zhhangBian/BOOM_chip/总线/总线.md

# 总结信号梳理和实例化

## AXI-Interconnect信号梳理

```verilog

/*
 * AXI4 interconnect
 */
module axi_interconnect #
(
    // Number of AXI inputs (slave interfaces)
    parameter S_COUNT = 4, // 接axi-bridge == 1
    // Number of AXI outputs (master interfaces)
    parameter M_COUNT = 4, // 接其他外设
    // Width of data bus in bits
    parameter DATA_WIDTH = 32, // 不用改
    // Width of address bus in bits
    parameter ADDR_WIDTH = 32, // 不用改
    // Width of wstrb (width of data bus in words)
    parameter STRB_WIDTH = (DATA_WIDTH/8), // 不用改
    // Width of ID signal 
    parameter ID_WIDTH = 8, // 取决于实际用的id位宽。官方包里的bridge是 4 ，但是这个模块里面似乎根本没用到 axi 的 id 信号
    // Propagate awuser signal
    parameter AWUSER_ENABLE = 0, // 不用改
    // Width of awuser signal
    parameter AWUSER_WIDTH = 1, // 不用改
    // Propagate wuser signal
    parameter WUSER_ENABLE = 0, // 不用改
    // Width of wuser signal
    parameter WUSER_WIDTH = 1, // 不用改
    // Propagate buser signal
    parameter BUSER_ENABLE = 0, // 不用功
    // Width of buser signal
    parameter BUSER_WIDTH = 1, // 不用改
    // Propagate aruser signal
    parameter ARUSER_ENABLE = 0, // 不用改
    // Width of aruser signal
    parameter ARUSER_WIDTH = 1, // 不用改
    // Propagate ruser signal
    parameter RUSER_ENABLE = 0, // 不用改
    // Width of ruser signal
    parameter RUSER_WIDTH = 1, // 不用改
    // Propagate ID field
    parameter FORWARD_ID = 0, // 应该不用改
    // Number of regions per master interface
    parameter M_REGIONS = 1, // 我们应该用默认值就行
    // Master interface base addresses
    // M_COUNT concatenated fields of M_REGIONS concatenated fields of ADDR_WIDTH bits
    // set to zero for default addressing based on M_ADDR_WIDTH
    parameter M_BASE_ADDR = 0, // 外设端的地址基址。没有特殊要求的话默认是 0 就好了
    // Master interface address widths
    // M_COUNT concatenated fields of M_REGIONS concatenated fields of 32 bits
    parameter M_ADDR_WIDTH = {M_COUNT{{M_REGIONS{32'd24}}}}, // 外设端的地址位宽。默认为均为24位，一般不得超出 ADDR_WIDTH 
    // Read connections between interfaces
    // M_COUNT concatenated fields of S_COUNT bits
    parameter M_CONNECT_READ = {M_COUNT{{S_COUNT{1'b1}}}}, // 取决于哪些设备是读
    // Write connections between interfaces
    // M_COUNT concatenated fields of S_COUNT bits
    parameter M_CONNECT_WRITE = {M_COUNT{{S_COUNT{1'b1}}}}, // 取决于哪些设备是写
    // Secure master (fail operations based on awprot/arprot)
    // M_COUNT bits
    parameter M_SECURE = {M_COUNT{1'b0}} // 我们应该不使用 secure 
)
(
    input  wire                            clk,
    input  wire                            rst,

    /*
     * AXI slave interfaces
     */
    input  wire [S_COUNT*ID_WIDTH-1:0]     s_axi_awid,
    input  wire [S_COUNT*ADDR_WIDTH-1:0]   s_axi_awaddr, // 
    input  wire [S_COUNT*8-1:0]            s_axi_awlen,
    input  wire [S_COUNT*3-1:0]            s_axi_awsize,
    input  wire [S_COUNT*2-1:0]            s_axi_awburst,
    input  wire [S_COUNT-1:0]              s_axi_awlock,
    input  wire [S_COUNT*4-1:0]            s_axi_awcache,
    input  wire [S_COUNT*3-1:0]            s_axi_awprot,
    input  wire [S_COUNT*4-1:0]            s_axi_awqos,
    input  wire [S_COUNT*AWUSER_WIDTH-1:0] s_axi_awuser,
    input  wire [S_COUNT-1:0]              s_axi_awvalid,
    output wire [S_COUNT-1:0]              s_axi_awready,
    input  wire [S_COUNT*DATA_WIDTH-1:0]   s_axi_wdata,
    input  wire [S_COUNT*STRB_WIDTH-1:0]   s_axi_wstrb,
    input  wire [S_COUNT-1:0]              s_axi_wlast,
    input  wire [S_COUNT*WUSER_WIDTH-1:0]  s_axi_wuser,
    input  wire [S_COUNT-1:0]              s_axi_wvalid,
    output wire [S_COUNT-1:0]              s_axi_wready,
    output wire [S_COUNT*ID_WIDTH-1:0]     s_axi_bid,
    output wire [S_COUNT*2-1:0]            s_axi_bresp,
    output wire [S_COUNT*BUSER_WIDTH-1:0]  s_axi_buser,
    output wire [S_COUNT-1:0]              s_axi_bvalid,
    input  wire [S_COUNT-1:0]              s_axi_bready,
    input  wire [S_COUNT*ID_WIDTH-1:0]     s_axi_arid,
    input  wire [S_COUNT*ADDR_WIDTH-1:0]   s_axi_araddr,
    input  wire [S_COUNT*8-1:0]            s_axi_arlen,
    input  wire [S_COUNT*3-1:0]            s_axi_arsize,
    input  wire [S_COUNT*2-1:0]            s_axi_arburst,
    input  wire [S_COUNT-1:0]              s_axi_arlock,
    input  wire [S_COUNT*4-1:0]            s_axi_arcache,
    input  wire [S_COUNT*3-1:0]            s_axi_arprot,
    input  wire [S_COUNT*4-1:0]            s_axi_arqos,
    input  wire [S_COUNT*ARUSER_WIDTH-1:0] s_axi_aruser,
    input  wire [S_COUNT-1:0]              s_axi_arvalid,
    output wire [S_COUNT-1:0]              s_axi_arready,
    output wire [S_COUNT*ID_WIDTH-1:0]     s_axi_rid,
    output wire [S_COUNT*DATA_WIDTH-1:0]   s_axi_rdata,
    output wire [S_COUNT*2-1:0]            s_axi_rresp,
    output wire [S_COUNT-1:0]              s_axi_rlast,
    output wire [S_COUNT*RUSER_WIDTH-1:0]  s_axi_ruser,
    output wire [S_COUNT-1:0]              s_axi_rvalid,
    input  wire [S_COUNT-1:0]              s_axi_rready,

    /*
     * AXI master interfaces
     */
    output wire [M_COUNT*ID_WIDTH-1:0]     m_axi_awid,
    output wire [M_COUNT*ADDR_WIDTH-1:0]   m_axi_awaddr,
    output wire [M_COUNT*8-1:0]            m_axi_awlen,
    output wire [M_COUNT*3-1:0]            m_axi_awsize,
    output wire [M_COUNT*2-1:0]            m_axi_awburst,
    output wire [M_COUNT-1:0]              m_axi_awlock,
    output wire [M_COUNT*4-1:0]            m_axi_awcache,
    output wire [M_COUNT*3-1:0]            m_axi_awprot,
    output wire [M_COUNT*4-1:0]            m_axi_awqos,
    output wire [M_COUNT*4-1:0]            m_axi_awregion,
    output wire [M_COUNT*AWUSER_WIDTH-1:0] m_axi_awuser,
    output wire [M_COUNT-1:0]              m_axi_awvalid,
    input  wire [M_COUNT-1:0]              m_axi_awready,
    output wire [M_COUNT*DATA_WIDTH-1:0]   m_axi_wdata,
    output wire [M_COUNT*STRB_WIDTH-1:0]   m_axi_wstrb,
    output wire [M_COUNT-1:0]              m_axi_wlast,
    output wire [M_COUNT*WUSER_WIDTH-1:0]  m_axi_wuser,
    output wire [M_COUNT-1:0]              m_axi_wvalid,
    input  wire [M_COUNT-1:0]              m_axi_wready,
    input  wire [M_COUNT*ID_WIDTH-1:0]     m_axi_bid,
    input  wire [M_COUNT*2-1:0]            m_axi_bresp,
    input  wire [M_COUNT*BUSER_WIDTH-1:0]  m_axi_buser,
    input  wire [M_COUNT-1:0]              m_axi_bvalid,
    output wire [M_COUNT-1:0]              m_axi_bready,
    output wire [M_COUNT*ID_WIDTH-1:0]     m_axi_arid,
    output wire [M_COUNT*ADDR_WIDTH-1:0]   m_axi_araddr,
    output wire [M_COUNT*8-1:0]            m_axi_arlen,
    output wire [M_COUNT*3-1:0]            m_axi_arsize,
    output wire [M_COUNT*2-1:0]            m_axi_arburst,
    output wire [M_COUNT-1:0]              m_axi_arlock,
    output wire [M_COUNT*4-1:0]            m_axi_arcache,
    output wire [M_COUNT*3-1:0]            m_axi_arprot,
    output wire [M_COUNT*4-1:0]            m_axi_arqos,
    output wire [M_COUNT*4-1:0]            m_axi_arregion,
    output wire [M_COUNT*ARUSER_WIDTH-1:0] m_axi_aruser,
    output wire [M_COUNT-1:0]              m_axi_arvalid,
    input  wire [M_COUNT-1:0]              m_axi_arready,
    input  wire [M_COUNT*ID_WIDTH-1:0]     m_axi_rid,
    input  wire [M_COUNT*DATA_WIDTH-1:0]   m_axi_rdata,
    input  wire [M_COUNT*2-1:0]            m_axi_rresp,
    input  wire [M_COUNT-1:0]              m_axi_rlast,
    input  wire [M_COUNT*RUSER_WIDTH-1:0]  m_axi_ruser,
    input  wire [M_COUNT-1:0]              m_axi_rvalid,
    output wire [M_COUNT-1:0]              m_axi_rready
);

```

## AXI-BRIDGE的信号梳理

```verilog
/*
 * AXI4 crossbar
 */
module axi_crossbar #
(
    // Number of AXI inputs (slave interfaces)
    parameter S_COUNT = 4, // 连接两个cache, == 2
    // Number of AXI outputs (master interfaces)
    parameter M_COUNT = 4, // 连接总线，== 1
    // Width of data bus in bits
    parameter DATA_WIDTH = 32, // 数据位宽
    // Width of address bus in bits
    parameter ADDR_WIDTH = 32, // 
    // Width of wstrb (width of data bus in words)
    parameter STRB_WIDTH = (DATA_WIDTH/8),
    // Input ID field width (from AXI masters)
    parameter S_ID_WIDTH = 8, // 官方包是 4
    // Output ID field width (towards AXI slaves)
    // Additional bits required for response routing
    parameter M_ID_WIDTH = S_ID_WIDTH+$clog2(S_COUNT),
    // Propagate awuser signal
    parameter AWUSER_ENABLE = 0, 
    // Width of awuser signal // 不需要
    parameter AWUSER_WIDTH = 1,
    // Propagate wuser signal
    parameter WUSER_ENABLE = 0,
    // Width of wuser signal
    parameter WUSER_WIDTH = 1,
    // Propagate buser signal
    parameter BUSER_ENABLE = 0,
    // Width of buser signal
    parameter BUSER_WIDTH = 1,
    // Propagate aruser signal
    parameter ARUSER_ENABLE = 0,
    // Width of aruser signal
    parameter ARUSER_WIDTH = 1,
    // Propagate ruser signal
    parameter RUSER_ENABLE = 0,
    // Width of ruser signal
    parameter RUSER_WIDTH = 1,
    // Number of concurrent unique IDs for each slave interface
    // S_COUNT concatenated fields of 32 bits
    parameter S_THREADS = {S_COUNT{32'd2}}, // 我们应该是设置成 1 吧
    // Number of concurrent operations for each slave interface
    // S_COUNT concatenated fields of 32 bits
    parameter S_ACCEPT = {S_COUNT{32'd16}}, // ???
    // Number of regions per master interface
    parameter M_REGIONS = 1,
    // Master interface base addresses
    // M_COUNT concatenated fields of M_REGIONS concatenated fields of ADDR_WIDTH bits
    // set to zero for default addressing based on M_ADDR_WIDTH
    parameter M_BASE_ADDR = 0,
    // Master interface address widths
    // M_COUNT concatenated fields of M_REGIONS concatenated fields of 32 bits
    parameter M_ADDR_WIDTH = {M_COUNT{{M_REGIONS{32'd24}}}},
    // Read connections between interfaces
    // M_COUNT concatenated fields of S_COUNT bits
    parameter M_CONNECT_READ = {M_COUNT{{S_COUNT{1'b1}}}}, // 应该是全部设置成 1，即都可读
    // Write connections between interfaces
    // M_COUNT concatenated fields of S_COUNT bits
    parameter M_CONNECT_WRITE = {M_COUNT{{S_COUNT{1'b1}}}}, // 设置成仅 DCache 侧可写
    // Number of concurrent operations for each master interface
    // M_COUNT concatenated fields of 32 bits
    parameter M_ISSUE = {M_COUNT{32'd4}}, // master侧支持的并发数量，感觉设置成 1 就行吧。毕竟只有一个master interface
    // Secure master (fail operations based on awprot/arprot)
    // M_COUNT bits
    parameter M_SECURE = {M_COUNT{1'b0}},
    // Slave interface AW channel register type (input)
    // 0 to bypass, 1 for simple buffer, 2 for skid buffer
    parameter S_AW_REG_TYPE = {S_COUNT{2'd0}},
    // Slave interface W channel register type (input)
    // 0 to bypass, 1 for simple buffer, 2 for skid buffer
    parameter S_W_REG_TYPE = {S_COUNT{2'd0}},
    // Slave interface B channel register type (output)
    // 0 to bypass, 1 for simple buffer, 2 for skid buffer
    parameter S_B_REG_TYPE = {S_COUNT{2'd1}},
    // Slave interface AR channel register type (input)
    // 0 to bypass, 1 for simple buffer, 2 for skid buffer
    parameter S_AR_REG_TYPE = {S_COUNT{2'd0}},
    // Slave interface R channel register type (output)
    // 0 to bypass, 1 for simple buffer, 2 for skid buffer
    parameter S_R_REG_TYPE = {S_COUNT{2'd2}},
    // Master interface AW channel register type (output)
    // 0 to bypass, 1 for simple buffer, 2 for skid buffer
    parameter M_AW_REG_TYPE = {M_COUNT{2'd1}}, // M开头的 REG_TYPE 都不会用到
    // Master interface W channel register type (output)
    // 0 to bypass, 1 for simple buffer, 2 for skid buffer
    parameter M_W_REG_TYPE = {M_COUNT{2'd2}},
    // Master interface B channel register type (input)
    // 0 to bypass, 1 for simple buffer, 2 for skid buffer
    parameter M_B_REG_TYPE = {M_COUNT{2'd0}},
    // Master interface AR channel register type (output)
    // 0 to bypass, 1 for simple buffer, 2 for skid buffer
    parameter M_AR_REG_TYPE = {M_COUNT{2'd1}},
    // Master interface R channel register type (input)
    // 0 to bypass, 1 for simple buffer, 2 for skid buffer
    parameter M_R_REG_TYPE = {M_COUNT{2'd0}}
)
(
    input  wire                             clk,
    input  wire                             rst,

    /*
     * AXI slave interfaces
     */
    input  wire [S_COUNT*S_ID_WIDTH-1:0]    s_axi_awid,
    input  wire [S_COUNT*ADDR_WIDTH-1:0]    s_axi_awaddr,
    input  wire [S_COUNT*8-1:0]             s_axi_awlen,
    input  wire [S_COUNT*3-1:0]             s_axi_awsize,
    input  wire [S_COUNT*2-1:0]             s_axi_awburst,
    input  wire [S_COUNT-1:0]               s_axi_awlock,
    input  wire [S_COUNT*4-1:0]             s_axi_awcache,
    input  wire [S_COUNT*3-1:0]             s_axi_awprot,
    input  wire [S_COUNT*4-1:0]             s_axi_awqos,
    input  wire [S_COUNT*AWUSER_WIDTH-1:0]  s_axi_awuser,
    input  wire [S_COUNT-1:0]               s_axi_awvalid,
    output wire [S_COUNT-1:0]               s_axi_awready,
    input  wire [S_COUNT*DATA_WIDTH-1:0]    s_axi_wdata,
    input  wire [S_COUNT*STRB_WIDTH-1:0]    s_axi_wstrb,
    input  wire [S_COUNT-1:0]               s_axi_wlast,
    input  wire [S_COUNT*WUSER_WIDTH-1:0]   s_axi_wuser,
    input  wire [S_COUNT-1:0]               s_axi_wvalid,
    output wire [S_COUNT-1:0]               s_axi_wready,
    output wire [S_COUNT*S_ID_WIDTH-1:0]    s_axi_bid,
    output wire [S_COUNT*2-1:0]             s_axi_bresp,
    output wire [S_COUNT*BUSER_WIDTH-1:0]   s_axi_buser,
    output wire [S_COUNT-1:0]               s_axi_bvalid,
    input  wire [S_COUNT-1:0]               s_axi_bready,
    input  wire [S_COUNT*S_ID_WIDTH-1:0]    s_axi_arid,
    input  wire [S_COUNT*ADDR_WIDTH-1:0]    s_axi_araddr,
    input  wire [S_COUNT*8-1:0]             s_axi_arlen,
    input  wire [S_COUNT*3-1:0]             s_axi_arsize,
    input  wire [S_COUNT*2-1:0]             s_axi_arburst,
    input  wire [S_COUNT-1:0]               s_axi_arlock,
    input  wire [S_COUNT*4-1:0]             s_axi_arcache,
    input  wire [S_COUNT*3-1:0]             s_axi_arprot,
    input  wire [S_COUNT*4-1:0]             s_axi_arqos,
    input  wire [S_COUNT*ARUSER_WIDTH-1:0]  s_axi_aruser,
    input  wire [S_COUNT-1:0]               s_axi_arvalid,
    output wire [S_COUNT-1:0]               s_axi_arready,
    output wire [S_COUNT*S_ID_WIDTH-1:0]    s_axi_rid,
    output wire [S_COUNT*DATA_WIDTH-1:0]    s_axi_rdata,
    output wire [S_COUNT*2-1:0]             s_axi_rresp,
    output wire [S_COUNT-1:0]               s_axi_rlast,
    output wire [S_COUNT*RUSER_WIDTH-1:0]   s_axi_ruser,
    output wire [S_COUNT-1:0]               s_axi_rvalid,
    input  wire [S_COUNT-1:0]               s_axi_rready,

    /*
     * AXI master interfaces
     */
    output wire [M_COUNT*M_ID_WIDTH-1:0]    m_axi_awid,
    output wire [M_COUNT*ADDR_WIDTH-1:0]    m_axi_awaddr,
    output wire [M_COUNT*8-1:0]             m_axi_awlen,
    output wire [M_COUNT*3-1:0]             m_axi_awsize,
    output wire [M_COUNT*2-1:0]             m_axi_awburst,
    output wire [M_COUNT-1:0]               m_axi_awlock,
    output wire [M_COUNT*4-1:0]             m_axi_awcache,
    output wire [M_COUNT*3-1:0]             m_axi_awprot,
    output wire [M_COUNT*4-1:0]             m_axi_awqos,
    output wire [M_COUNT*4-1:0]             m_axi_awregion,
    output wire [M_COUNT*AWUSER_WIDTH-1:0]  m_axi_awuser,
    output wire [M_COUNT-1:0]               m_axi_awvalid,
    input  wire [M_COUNT-1:0]               m_axi_awready,
    output wire [M_COUNT*DATA_WIDTH-1:0]    m_axi_wdata,
    output wire [M_COUNT*STRB_WIDTH-1:0]    m_axi_wstrb,
    output wire [M_COUNT-1:0]               m_axi_wlast,
    output wire [M_COUNT*WUSER_WIDTH-1:0]   m_axi_wuser,
    output wire [M_COUNT-1:0]               m_axi_wvalid,
    input  wire [M_COUNT-1:0]               m_axi_wready,
    input  wire [M_COUNT*M_ID_WIDTH-1:0]    m_axi_bid,
    input  wire [M_COUNT*2-1:0]             m_axi_bresp,
    input  wire [M_COUNT*BUSER_WIDTH-1:0]   m_axi_buser,
    input  wire [M_COUNT-1:0]               m_axi_bvalid,
    output wire [M_COUNT-1:0]               m_axi_bready,
    output wire [M_COUNT*M_ID_WIDTH-1:0]    m_axi_arid,
    output wire [M_COUNT*ADDR_WIDTH-1:0]    m_axi_araddr,
    output wire [M_COUNT*8-1:0]             m_axi_arlen,
    output wire [M_COUNT*3-1:0]             m_axi_arsize,
    output wire [M_COUNT*2-1:0]             m_axi_arburst,
    output wire [M_COUNT-1:0]               m_axi_arlock,
    output wire [M_COUNT*4-1:0]             m_axi_arcache,
    output wire [M_COUNT*3-1:0]             m_axi_arprot,
    output wire [M_COUNT*4-1:0]             m_axi_arqos,
    output wire [M_COUNT*4-1:0]             m_axi_arregion,
    output wire [M_COUNT*ARUSER_WIDTH-1:0]  m_axi_aruser,
    output wire [M_COUNT-1:0]               m_axi_arvalid,
    input  wire [M_COUNT-1:0]               m_axi_arready,
    input  wire [M_COUNT*M_ID_WIDTH-1:0]    m_axi_rid,
    input  wire [M_COUNT*DATA_WIDTH-1:0]    m_axi_rdata,
    input  wire [M_COUNT*2-1:0]             m_axi_rresp,
    input  wire [M_COUNT-1:0]               m_axi_rlast,
    input  wire [M_COUNT*RUSER_WIDTH-1:0]   m_axi_ruser,
    input  wire [M_COUNT-1:0]               m_axi_rvalid,
    output wire [M_COUNT-1:0]               m_axi_rready
);
```

```Verilog
// AXI-BRIDGE Instance
module axi_crossbar #
(
    S_COUNT         = 2, // 连接两个cache, == 2
    M_COUNT         = 1, // 连接总线，== 1
    DATA_WIDTH = 32, // TODO: 数据位宽
    ADDR_WIDTH      = 32, // 地址位宽，应该是32位吧
    // STRB_WIDTH = (DATA_WIDTH/8), // 使用默认值
    S_ID_WIDTH      = 4, // 官方包是 4 
    // parameter M_ID_WIDTH = S_ID_WIDTH+$clog2(S_COUNT), // 使用默认值
    // UESR SIGNAL信号全部都不需要
    // parameter S_THREADS = {S_COUNT{32'd2}}, // 我们应该是设置成 1 吧 TODO: 暂时使用默认值
    // parameter S_ACCEPT = {S_COUNT{32'd16}}, // TODO: 暂时使用默认值
    // parameter M_REGIONS = 1, // 使用默认值
    // parameter M_BASE_ADDR = 0, // 就一个master，设置成0就好
    // Master interface address widths
    // M_COUNT concatenated fields of M_REGIONS concatenated fields of 32 bits
    M_ADDR_WIDTH    = {M_COUNT{{M_REGIONS{32'd32}}}}, // ICACHE和DCACHE的数据位宽应该都是32位？TODO: 取决于物理地址宽度
    // parameter M_CONNECT_READ = {M_COUNT{{S_COUNT{1'b1}}}}, // 应该是全部设置成 1，即都可读
    M_CONNECT_WRITE = {M_COUNT{2'b01}}, // 设置成仅 DCache 侧可写
    // parameter M_ISSUE = {M_COUNT{32'd4}}, // TODO: master侧支持的并发数量, Number of concurrent operations for each master interface
    // parameter M_SECURE = {M_COUNT{1'b0}}, // 我们不需要SECURE

    // 0 to bypass, 1 for simple buffer, 2 for skid buffer
    // TODO: 暂时使用默认值
    // parameter S_AW_REG_TYPE = {S_COUNT{2'd0}},
    // parameter S_W_REG_TYPE = {S_COUNT{2'd0}},
    // parameter S_B_REG_TYPE = {S_COUNT{2'd1}},
    // parameter S_AR_REG_TYPE = {S_COUNT{2'd0}},
    // parameter S_R_REG_TYPE = {S_COUNT{2'd2}},

    // M开头的 REG_TYPE 根本不会用到
    // parameter M_AW_REG_TYPE = {M_COUNT{2'd1}}, 
    // parameter M_W_REG_TYPE = {M_COUNT{2'd2}},
    // parameter M_B_REG_TYPE = {M_COUNT{2'd0}},
    // parameter M_AR_REG_TYPE = {M_COUNT{2'd1}},
    // parameter M_R_REG_TYPE = {M_COUNT{2'd0}}
)
(
    input  wire                             clk,
    input  wire                             rst,

    /*
     * AXI slave interfaces
     */
    input  wire [S_COUNT*S_ID_WIDTH-1:0]    s_axi_awid,
    input  wire [S_COUNT*ADDR_WIDTH-1:0]    s_axi_awaddr,
    input  wire [S_COUNT*8-1:0]             s_axi_awlen,
    input  wire [S_COUNT*3-1:0]             s_axi_awsize,
    input  wire [S_COUNT*2-1:0]             s_axi_awburst,
    input  wire [S_COUNT-1:0]               s_axi_awlock,
    input  wire [S_COUNT*4-1:0]             s_axi_awcache,
    input  wire [S_COUNT*3-1:0]             s_axi_awprot,
    input  wire [S_COUNT*4-1:0]             s_axi_awqos,
    input  wire [S_COUNT*AWUSER_WIDTH-1:0]  s_axi_awuser,
    input  wire [S_COUNT-1:0]               s_axi_awvalid,
    output wire [S_COUNT-1:0]               s_axi_awready,
    input  wire [S_COUNT*DATA_WIDTH-1:0]    s_axi_wdata,
    input  wire [S_COUNT*STRB_WIDTH-1:0]    s_axi_wstrb,
    input  wire [S_COUNT-1:0]               s_axi_wlast,
    input  wire [S_COUNT*WUSER_WIDTH-1:0]   s_axi_wuser,
    input  wire [S_COUNT-1:0]               s_axi_wvalid,
    output wire [S_COUNT-1:0]               s_axi_wready,
    output wire [S_COUNT*S_ID_WIDTH-1:0]    s_axi_bid,
    output wire [S_COUNT*2-1:0]             s_axi_bresp,
    output wire [S_COUNT*BUSER_WIDTH-1:0]   s_axi_buser,
    output wire [S_COUNT-1:0]               s_axi_bvalid,
    input  wire [S_COUNT-1:0]               s_axi_bready,
    input  wire [S_COUNT*S_ID_WIDTH-1:0]    s_axi_arid,
    input  wire [S_COUNT*ADDR_WIDTH-1:0]    s_axi_araddr,
    input  wire [S_COUNT*8-1:0]             s_axi_arlen,
    input  wire [S_COUNT*3-1:0]             s_axi_arsize,
    input  wire [S_COUNT*2-1:0]             s_axi_arburst,
    input  wire [S_COUNT-1:0]               s_axi_arlock,
    input  wire [S_COUNT*4-1:0]             s_axi_arcache,
    input  wire [S_COUNT*3-1:0]             s_axi_arprot,
    input  wire [S_COUNT*4-1:0]             s_axi_arqos,
    input  wire [S_COUNT*ARUSER_WIDTH-1:0]  s_axi_aruser,
    input  wire [S_COUNT-1:0]               s_axi_arvalid,
    output wire [S_COUNT-1:0]               s_axi_arready,
    output wire [S_COUNT*S_ID_WIDTH-1:0]    s_axi_rid,
    output wire [S_COUNT*DATA_WIDTH-1:0]    s_axi_rdata,
    output wire [S_COUNT*2-1:0]             s_axi_rresp,
    output wire [S_COUNT-1:0]               s_axi_rlast,
    output wire [S_COUNT*RUSER_WIDTH-1:0]   s_axi_ruser,
    output wire [S_COUNT-1:0]               s_axi_rvalid,
    input  wire [S_COUNT-1:0]               s_axi_rready,

    /*
     * AXI master interfaces
     */
    output wire [M_COUNT*M_ID_WIDTH-1:0]    m_axi_awid,
    output wire [M_COUNT*ADDR_WIDTH-1:0]    m_axi_awaddr,
    output wire [M_COUNT*8-1:0]             m_axi_awlen,
    output wire [M_COUNT*3-1:0]             m_axi_awsize,
    output wire [M_COUNT*2-1:0]             m_axi_awburst,
    output wire [M_COUNT-1:0]               m_axi_awlock,
    output wire [M_COUNT*4-1:0]             m_axi_awcache,
    output wire [M_COUNT*3-1:0]             m_axi_awprot,
    output wire [M_COUNT*4-1:0]             m_axi_awqos,
    output wire [M_COUNT*4-1:0]             m_axi_awregion,
    output wire [M_COUNT*AWUSER_WIDTH-1:0]  m_axi_awuser,
    output wire [M_COUNT-1:0]               m_axi_awvalid,
    input  wire [M_COUNT-1:0]               m_axi_awready,
    output wire [M_COUNT*DATA_WIDTH-1:0]    m_axi_wdata,
    output wire [M_COUNT*STRB_WIDTH-1:0]    m_axi_wstrb,
    output wire [M_COUNT-1:0]               m_axi_wlast,
    output wire [M_COUNT*WUSER_WIDTH-1:0]   m_axi_wuser,
    output wire [M_COUNT-1:0]               m_axi_wvalid,
    input  wire [M_COUNT-1:0]               m_axi_wready,
    input  wire [M_COUNT*M_ID_WIDTH-1:0]    m_axi_bid,
    input  wire [M_COUNT*2-1:0]             m_axi_bresp,
    input  wire [M_COUNT*BUSER_WIDTH-1:0]   m_axi_buser,
    input  wire [M_COUNT-1:0]               m_axi_bvalid,
    output wire [M_COUNT-1:0]               m_axi_bready,
    output wire [M_COUNT*M_ID_WIDTH-1:0]    m_axi_arid,
    output wire [M_COUNT*ADDR_WIDTH-1:0]    m_axi_araddr,
    output wire [M_COUNT*8-1:0]             m_axi_arlen,
    output wire [M_COUNT*3-1:0]             m_axi_arsize,
    output wire [M_COUNT*2-1:0]             m_axi_arburst,
    output wire [M_COUNT-1:0]               m_axi_arlock,
    output wire [M_COUNT*4-1:0]             m_axi_arcache,
    output wire [M_COUNT*3-1:0]             m_axi_arprot,
    output wire [M_COUNT*4-1:0]             m_axi_arqos,
    output wire [M_COUNT*4-1:0]             m_axi_arregion,
    output wire [M_COUNT*ARUSER_WIDTH-1:0]  m_axi_aruser,
    output wire [M_COUNT-1:0]               m_axi_arvalid,
    input  wire [M_COUNT-1:0]               m_axi_arready,
    input  wire [M_COUNT*M_ID_WIDTH-1:0]    m_axi_rid,
    input  wire [M_COUNT*DATA_WIDTH-1:0]    m_axi_rdata,
    input  wire [M_COUNT*2-1:0]             m_axi_rresp,
    input  wire [M_COUNT-1:0]               m_axi_rlast,
    input  wire [M_COUNT*RUSER_WIDTH-1:0]   m_axi_ruser,
    input  wire [M_COUNT-1:0]               m_axi_rvalid,
    output wire [M_COUNT-1:0]               m_axi_rready
);
```

```Verilog
// AXI-Interconnect

现在默认的 Interconnect 至少要有GPIO, Data RAM 和 Inst RAM
```
