zhhangBian/BOOM_chip/report/性能记录.md

## IPC

|IPC|CACHE=4|CACHE=8| 某一版 | 最终版 |
|---|---|---|---|---|
| bitcount | 1.09  | 1.04 | 1.0403 | 1.0760 |
| bubble_sort | 0.62  | 0.6097 | 0.6097 | 0.6351 |
| coremark | 0.80  | 0.8185 | 0.8179 | 0.8032 |
| crc32 | 0.82  | 0.8099 | 0.8098 | 0.8079 |
| dhrystone | 0.67  | 0.5438 | 0.5440 | 0.5414 |
| fireye_D1 | | 0.4744 | 0.4728 | 0.4662 |
| fireye_I2 | | 0.9799 | 0.9799 | 0.9725 |
| inner_product | | 0.5178 | 0.5179 | 0.5113 |
| lookup_table | | 0.5526 | 0.5521 | 0.5473 |
| loop_induction | | 0.6397 | 0.6393 | 0.6296 |
| minmax_sequence | | 0.6190 | 0.6187 | 0.6190 |
| my_memcmp | | 0.6190 | 0.8179 | 0.6190 |
| quick_sort | 0.5238 | 0.5365 | 0.5377 | 0.5349 |
| select_sort | 1.06  | 1.0631 | 1.0631 | 1.0549 |
| sha | 0.76 | 1.0039 | 1.0034 | 1.0050 |
| stream_copy | 0.77  | 0.6464 | 0.6464 | 0.6175 |
| stringsearch | 0.67 | 0.6808 | 0.6808 | 0.6736 |

## 分支预测率

| 测试点 | 分支预测率  | 最终版 |
| --- | --- | --- |
| bitcount | 90.4709 | 92.6255 |
| bubble_sort | 84.2032 | 85.9884 |
| coremark | 89.4942 | 89.000 |
| crc32 | 96.8072 | 96.7978 |
| dhrystone | 94.3255 | 94.4058 |
| fireye_D1 | 93.8269 | 93.8192 |
| fireye_I2 | 95.3621 | 95.2763 |
| inner_product | 99.7047 | 99.7010 |
| lookup_table | 87.7350 | 87.7097 |
| loop_induction  | 91.2892 | 90.9288 |
| minmax_sequence | 84.6863 | 84.6069 |
| my_memcmp | 84.6863 | 84.6069 |
| quick_sort | 75.4297 | 75.4120 |
| select_sort | 95.8320 | 95.8258 |
| sha | 97.0223 | 97.0205 |
| stream_copy | 96.4569 | 96.3435 |
| stringsearch | 95.5413 | 95.1795 |
