zhhangBian/BOOM_chip/Design/P级所需的控制信号.md

R级向P级传递的数据：

1. 基本数据类型：
    1. 前端的立即数、PC、寄存器值、寄存器有效和需要的寄存器（重命名后）
    2. 后端需要的译码信息（指令种类）
    3. 和ROB的交互信息：ROB接口读出的所需数据（包括CDB传来的数据，在顶层模块做好转发）
2. 一些过程中产生的控制信号
    1. 所需数据是在ARF/PRF中
    2. 数据是否准备好
3. 和R级的握手信号
