zhhangBian/BOOM_chip/Design/[BOOM]命名规范.md

## 文件命名规范

1. 使用`basic_`表示基础文件。
2. 头文件命名为`a_`
3. 每一级的原件使用不同的级作为前缀
    - B 分支预测
    - F 取值
    - D 译码
    - R 重命名
    - P 分发
    - I 发射
    - E 执行
    - CDB CDB
    - C 提交
4. 上层区分为前端和后端
5. 端口命名使用不同的后缀
    - _i 表示外部输入
    - _o 表示外部输出
6. 编写代码的时候使用一个单独的宏定义表，写完代码后更新到仓库中，加上注释
