zhhangBian/BOOM_chip/BPU/BPU.jpg

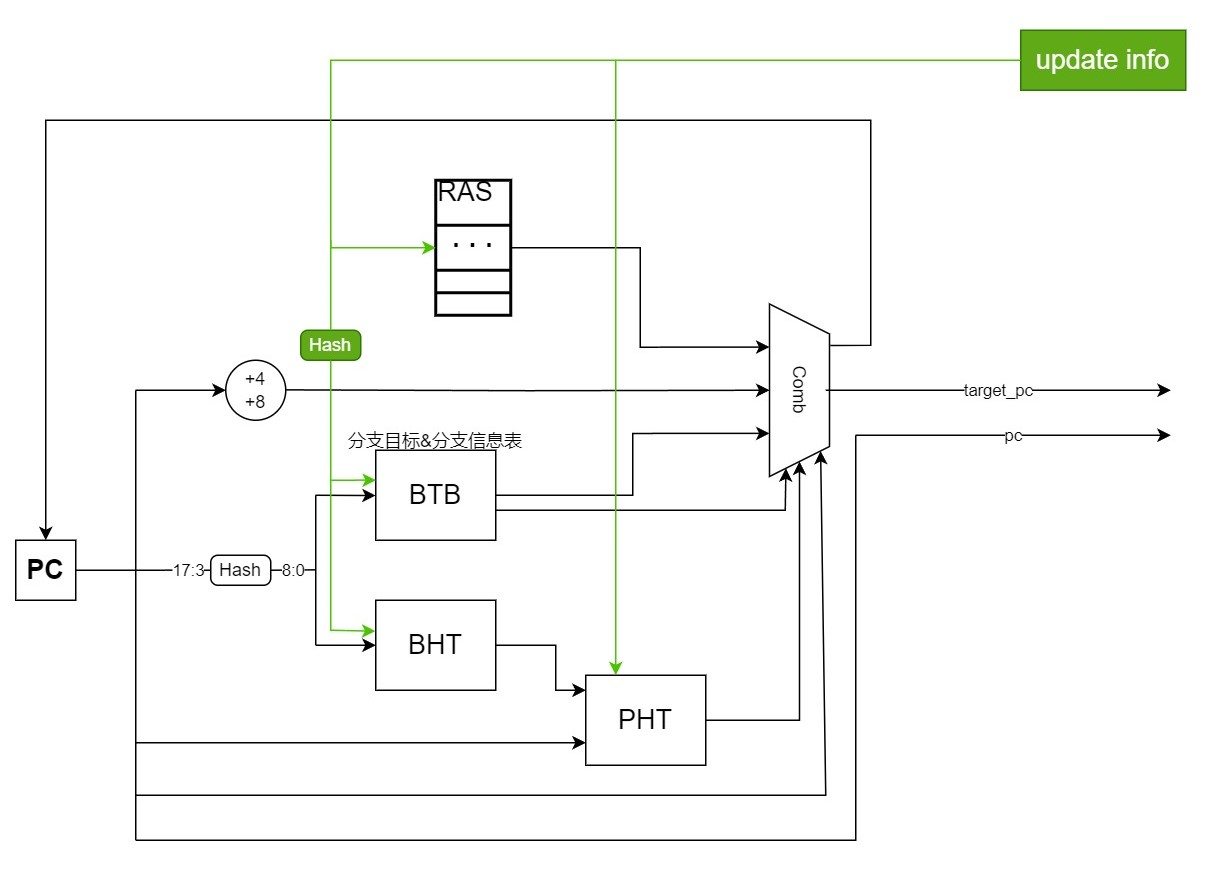
BPU/BPU.jpg
