zhhangBian/BOOM_chip/BPU/BPU设计.jpg

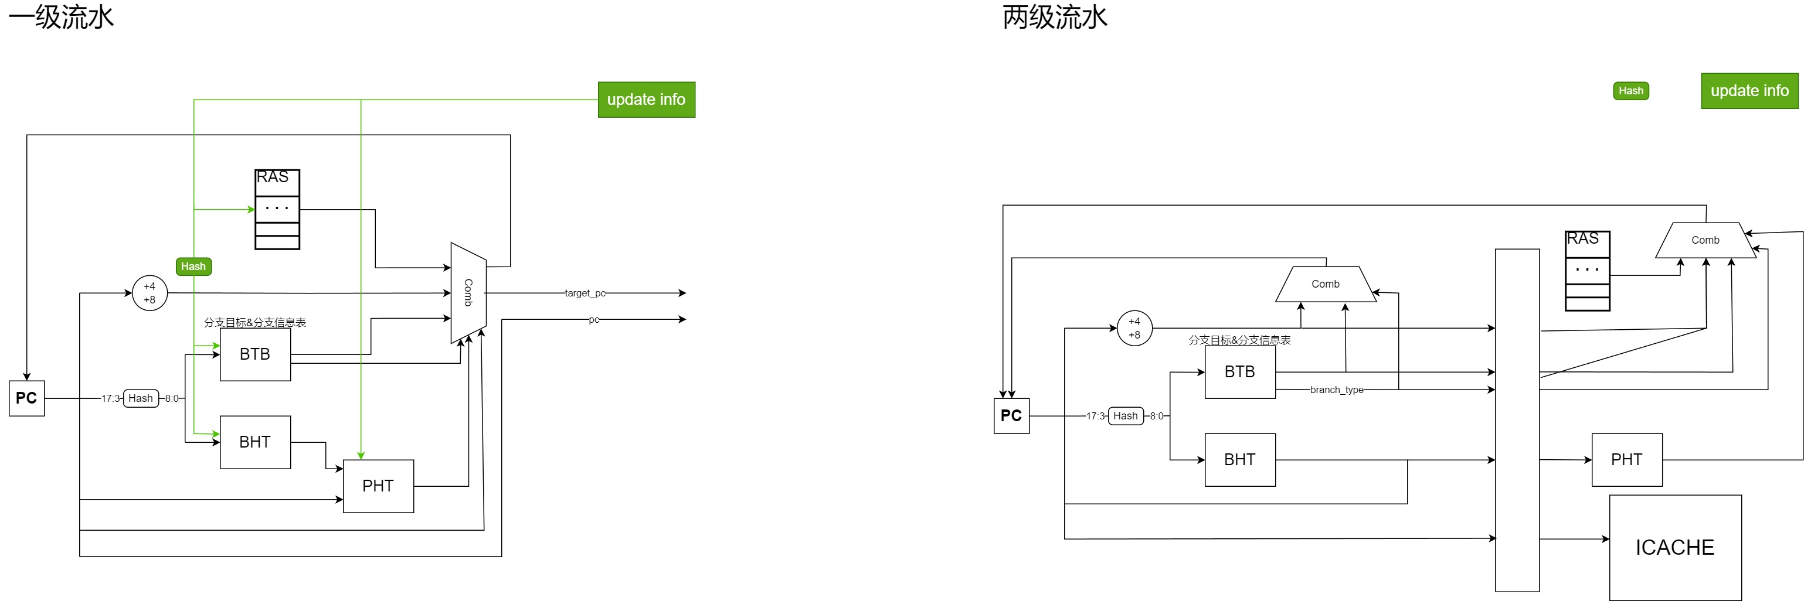
BPU/BPU设计.jpg
