zhhangBian/BOOM_chip/report/images/Structure.png

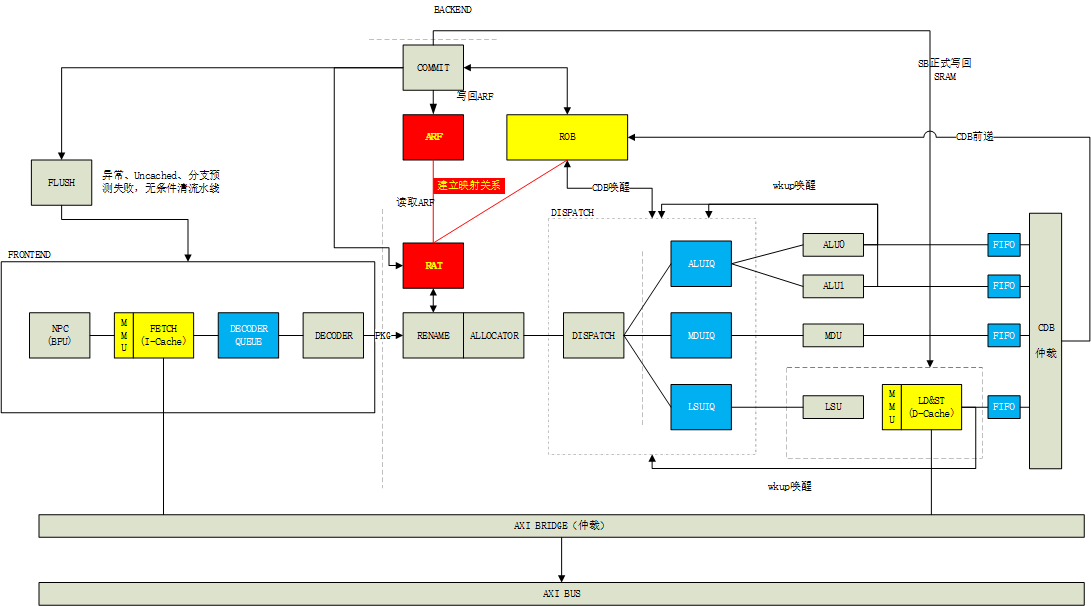
report/images/Structure.png
