zhhangBian/BOOM_chip/report/images/wkup_forward.png

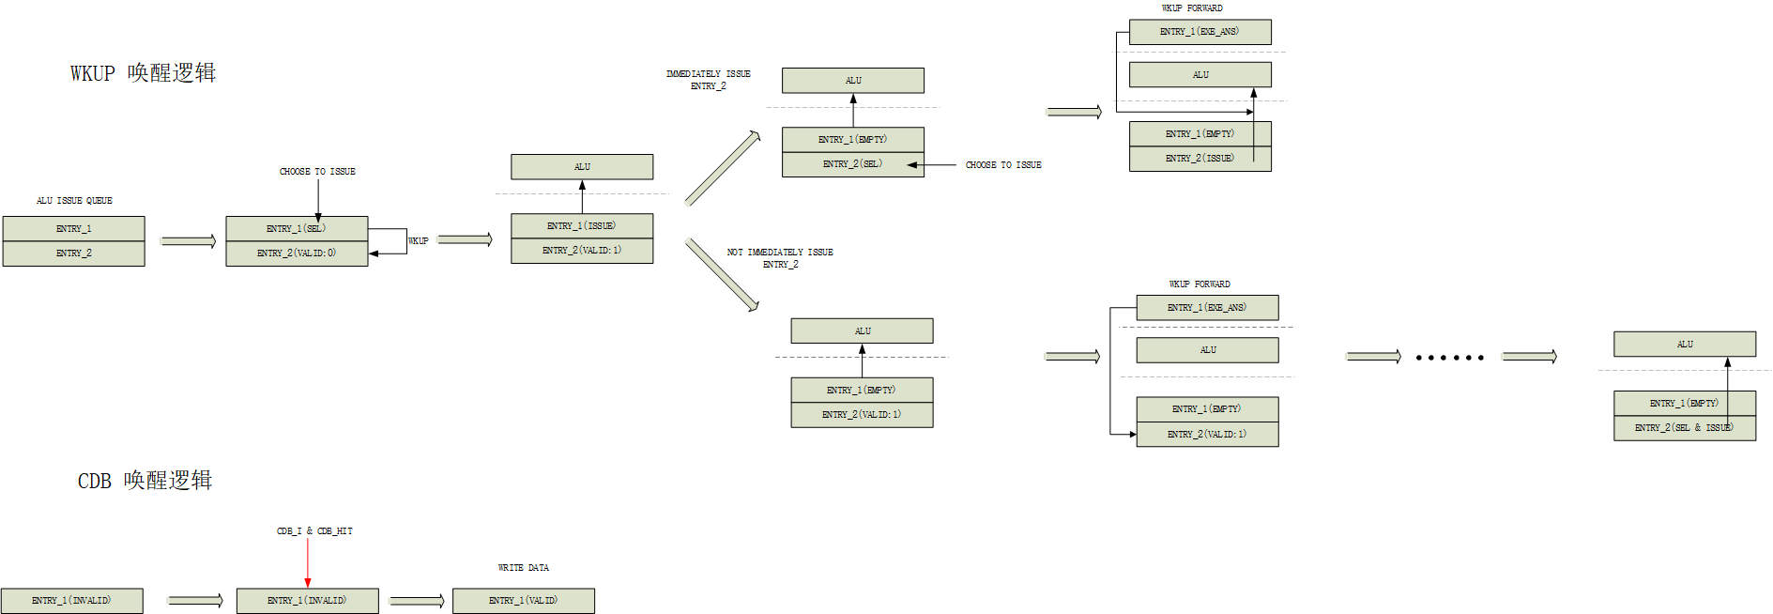
report/images/wkup_forward.png
