zhhangBian/BOOM_chip/(threads)

Thread 1 (2024-11-20):

接入到chiplab环境后卡住

pointerliu, 2024-11-20:
你好，请问BOOM-chip有没有对chiplab做出修改，我在尝试将BOOM-chip接入到chiplab环境中，运行func19时，仿真输出Start后卡住，请问可能原因会是什么？

```
Using simulated 4096MB RAM
Verilator Simulation Start.
Addressing configuration for axi_crossbar_addr instance TOP.axi_crossbar.axi_crossbar_wr_inst.s_ifaces[0].addr_inst
 0 ( 0): 00000000 / 24 -- 00000000-00ffffff
 1 ( 0): 01000000 / 24 -- 01000000-01ffffff
 2 ( 0): 02000000 / 24 -- 02000000-02ffffff
 3 ( 0): 03000000 / 24 -- 03000000-03ffffff
Addressing configuration for axi_crossbar_addr instance TOP.axi_crossbar.axi_crossbar_wr_inst.s_ifaces[1].addr_inst
 0 ( 0): 00000000 / 24 -- 00000000-00ffffff
 1 ( 0): 01000000 / 24 -- 01000000-01ffffff
 2 ( 0): 02000000 / 24 -- 02000000-02ffffff
 3 ( 0): 03000000 / 24 -- 03000000-03ffffff
Addressing configuration for axi_crossbar_addr instance TOP.axi_crossbar.axi_crossbar_wr_inst.s_ifaces[2].addr_inst
 0 ( 0): 00000000 / 24 -- 00000000-00ffffff
 1 ( 0): 01000000 / 24 -- 01000000-01ffffff
 2 ( 0): 02000000 / 24 -- 02000000-02ffffff
 3 ( 0): 03000000 / 24 -- 03000000-03ffffff
Addressing configuration for axi_crossbar_addr instance TOP.axi_crossbar.axi_crossbar_wr_inst.s_ifaces[3].addr_inst
 0 ( 0): 00000000 / 24 -- 00000000-00ffffff
 1 ( 0): 01000000 / 24 -- 01000000-01ffffff
 2 ( 0): 02000000 / 24 -- 02000000-02ffffff
 3 ( 0): 03000000 / 24 -- 03000000-03ffffff
Addressing configuration for axi_crossbar_addr instance TOP.axi_crossbar.axi_crossbar_rd_inst.s_ifaces[0].addr_inst
 0 ( 0): 00000000 / 24 -- 00000000-00ffffff
 1 ( 0): 01000000 / 24 -- 01000000-01ffffff
 2 ( 0): 02000000 / 24 -- 02000000-02ffffff
 3 ( 0): 03000000 / 24 -- 03000000-03ffffff
Addressing configuration for axi_crossbar_addr instance TOP.axi_crossbar.axi_crossbar_rd_inst.s_ifaces[1].addr_inst
 0 ( 0): 00000000 / 24 -- 00000000-00ffffff
 1 ( 0): 01000000 / 24 -- 01000000-01ffffff
 2 ( 0): 02000000 / 24 -- 02000000-02ffffff
 3 ( 0): 03000000 / 24 -- 03000000-03ffffff
Addressing configuration for axi_crossbar_addr instance TOP.axi_crossbar.axi_crossbar_rd_inst.s_ifaces[2].addr_inst
 0 ( 0): 00000000 / 24 -- 00000000-00ffffff
 1 ( 0): 01000000 / 24 -- 01000000-01ffffff
 2 ( 0): 02000000 / 24 -- 02000000-02ffffff
 3 ( 0): 03000000 / 24 -- 03000000-03ffffff
Addressing configuration for axi_crossbar_addr instance TOP.axi_crossbar.axi_crossbar_rd_inst.s_ifaces[3].addr_inst
 0 ( 0): 00000000 / 24 -- 00000000-00ffffff
 1 ( 0): 01000000 / 24 -- 01000000-01ffffff
 2 ( 0): 02000000 / 24 -- 02000000-02ffffff
 3 ( 0): 03000000 / 24 -- 03000000-03ffffff
Addressing configuration for axi_interconnect instance TOP.axi_interconnect
 0 ( 0): 00000000 / 24 -- 00000000-00ffffff
 1 ( 0): 01000000 / 24 -- 01000000-01ffffff
 2 ( 0): 02000000 / 24 -- 02000000-02ffffff
 3 ( 0): 03000000 / 24 -- 03000000-03ffffff
--diff is not given, try to use $(CHIPLAB_HOME)/toolchains/nemu/la32r-nemu-interpreter-so by default
Using /home/ubuntu/chiplab/toolchains/nemu/la32r-nemu-interpreter-so for difftest
[NEMU] ####### INIT HERE ########
[NEMU] TLB_ENTRY = 32
[NEMU] PALEN = 32
Start

```

pointerliu, 2024-11-21:
谢谢，define _DIFFTEST 就可以终止了

Closed 2024-11-21.
