zhhangBian/BOOM_chip/rtl/p_dispatch.sv

`include "a_defines.svh"

module dispatch #(    
) (
    input logic clk,
    input logic rst_n,
    input logic flush_i,
    input cdb_dispatch_pkg_t    cdb_dispatch_i [1 : 0],
    input rob_dispatch_pkg_t    rob_dispatch_i [1 : 0],
    
    output dispatch_rob_pkg_t   dispatch_rob_o [1 : 0],

    handshake_if.receiver r_p_receiver,

    handshake_if.sender              p_alu_sender_0, // 2 alu queues
    handshake_if.sender              p_alu_sender_1,
    handshake_if.sender              p_lsu_sender,
    handshake_if.sender              p_mdu_sender
);

decode_info_t p_di [1:0];

// handshake signal
logic  lsu_ready, mdu_ready;
logic  [1 : 0]    alu_ready;
assign alu_ready = {p_alu_sender_1.ready, p_alu_sender_0.ready};
assign lsu_ready = p_lsu_sender.ready;
assign mdu_ready = p_mdu_sender.ready;
r_p_pkg_t   r_p_pkg;
assign r_p_receiver.ready = (&alu_ready) & lsu_ready & mdu_ready;
assign r_p_pkg            = r_p_receiver.data;

always_comb begin
    for (integer i = 0; i < 2; i++) begin
        dispatch_rob_o[i].areg      = r_p_pkg.areg[i];
        dispatch_rob_o[i].preg      = r_p_pkg.preg[i];
        dispatch_rob_o[i].src_preg  = {r_p_pkg.src_preg[i * 2 + 1],r_p_pkg.src_preg[i * 2]};
        dispatch_rob_o[i].pc        = r_p_pkg.pc[i];
        `ifdef _DIFFTEST
        dispatch_rob_o[i].instr        = r_p_pkg.instr[i];
        `endif
        dispatch_rob_o[i].issue     = r_p_pkg.r_valid[i] & r_p_receiver.ready & {2{!flush_i}};
        dispatch_rob_o[i].w_reg     = r_p_pkg.w_reg[i];
        dispatch_rob_o[i].w_mem     = r_p_pkg.w_mem[i];
        dispatch_rob_o[i].check     = r_p_pkg.check[i];
        dispatch_rob_o[i].r_valid   = r_p_pkg.r_valid[i];

        dispatch_rob_o[i].addr_imm  = r_p_pkg.addr_imm[i];

        // 指令类型
        dispatch_rob_o[i].alu_type = r_p_pkg.alu_type[i]; // 指令类型
        dispatch_rob_o[i].mdu_type = r_p_pkg.mdu_type[i];
        dispatch_rob_o[i].lsu_type = r_p_pkg.lsu_type[i];
        dispatch_rob_o[i].flush_inst = r_p_pkg.flush_inst[i];
        dispatch_rob_o[i].jump_inst = r_p_pkg.jump_inst[i];
        dispatch_rob_o[i].priv_inst = r_p_pkg.priv_inst[i];
        dispatch_rob_o[i].rdcnt_inst = r_p_pkg.rdcnt_inst[i];
        dispatch_rob_o[i].tlb_inst = r_p_pkg.tlb_inst[i];
        // control info, temp, 根据需要自己调整
        dispatch_rob_o[i].predict_info = r_p_pkg.predict_infos[i];
        // dispatch_rob_o[i].if_jump = r_p_pkg.if_jump[i]; // 是否跳转 TODO: 什么意思？
        // 特殊指令独热码
        dispatch_rob_o[i].break_inst = r_p_pkg.break_inst[i];
        dispatch_rob_o[i].cacop_inst = r_p_pkg.cacop_inst[i]; // lsu iq
        dispatch_rob_o[i].dbar_inst = r_p_pkg.dbar_inst[i];
        dispatch_rob_o[i].ertn_inst = r_p_pkg.ertn_inst[i];
        dispatch_rob_o[i].ibar_inst = r_p_pkg.ibar_inst[i];
        dispatch_rob_o[i].idle_inst = r_p_pkg.idle_inst[i];
        dispatch_rob_o[i].invtlb_inst = r_p_pkg.invtlb_inst[i];
        dispatch_rob_o[i].ll_inst = r_p_pkg.ll_inst[i]; // lsu iq

        dispatch_rob_o[i].rdcntid_inst = r_p_pkg.rdcntid_inst[i];
        dispatch_rob_o[i].rdcntvh_inst = r_p_pkg.rdcntvh_inst[i];
        dispatch_rob_o[i].rdcntvl_inst = r_p_pkg.rdcntvl_inst[i];

        dispatch_rob_o[i].sc_inst = r_p_pkg.sc_inst[i]; // lsu iq
        dispatch_rob_o[i].syscall_inst = r_p_pkg.syscall_inst[i];
        dispatch_rob_o[i].tlbfill_inst = r_p_pkg.tlbfill_inst[i];
        dispatch_rob_o[i].tlbrd_inst = r_p_pkg.tlbrd_inst[i];
        dispatch_rob_o[i].tlbsrch_inst = r_p_pkg.tlbsrch_inst[i];
        dispatch_rob_o[i].tlbwr_inst = r_p_pkg.tlbwr_inst[i];

        dispatch_rob_o[i].csr_op_type = r_p_pkg.csr_op_type[i];
        dispatch_rob_o[i].csr_num = r_p_pkg.csr_num[i];
        dispatch_rob_o[i].inst_4_0  = r_p_pkg.inst_4_0[i];
        dispatch_rob_o[i].decode_err = r_p_pkg.decode_err[i];

        // branch
        dispatch_rob_o[i].is_branch = r_p_pkg.is_branch[i];
        dispatch_rob_o[i].br_type = r_p_pkg.br_type[i];
        dispatch_rob_o[i].jirl_as_call = r_p_pkg.jirl_as_call[i];
        dispatch_rob_o[i].jirl_as_normal = r_p_pkg.jirl_as_normal[i];
        dispatch_rob_o[i].jirl_as_ret = r_p_pkg.jirl_as_ret[i];
    end
end


// data src:
// rob
// arf
// cdb
// imm
// 做一个多路选择mux
logic [3 : 0][31 : 0] cdb_data_issue;
logic [3 : 0]         cdb_data_hit;
logic [3 : 0][31 : 0] rob_data_issue;
logic [3 : 0]         rob_data_hit;
// data from cdb, rob;
assign rob_data_issue = {rob_dispatch_i[1].rob_data, rob_dispatch_i[0].rob_data};
assign rob_data_hit   = {rob_dispatch_i[1].rob_complete, rob_dispatch_i[0].rob_complete};
always_comb begin
    for (integer i = 0; i < 4; i++) begin
        cdb_data_issue[i] = '0;
        cdb_data_hit[i]   = '0;
        for (integer j = 0; j < 2; j++) begin
            if (cdb_dispatch_i[j].w_preg == r_p_pkg.src_preg[i] 
                && cdb_dispatch_i[j].w_reg == '1) begin
                cdb_data_issue[i] |= cdb_dispatch_i[j].w_data;
                cdb_data_hit[i]   |= '1;
            end
        end
    end
end
// mux 选择 arf-imm, cdb-rob
logic [3 : 0][31: 0] gen_data; 
logic [3 : 0][31: 0] rob_data;
logic [3 : 0][31: 0] sel_data;
logic [3 : 0]        data_valid; 
always_comb begin
    for (integer i = 0; i < 4; i++) begin
        gen_data[i] = r_p_pkg.use_imm[i]? r_p_pkg.data_imm[i[1]] : r_p_pkg.arf_data[i];
        rob_data[i] = cdb_data_hit[i]   ? cdb_data_issue[i] : rob_data_issue[i];
        sel_data[i] = r_p_pkg.data_valid[i] ? gen_data[i] : rob_data[i];
        data_valid[i] = cdb_data_hit[i] | r_p_pkg.data_valid[i] | rob_data_hit[i];
    end
    data_valid[2] &= !(r_p_pkg.src_preg[2] == r_p_pkg.preg[0] && r_p_pkg.w_reg[0] && r_p_pkg.r_valid[0]) || !r_p_pkg.reg_need[2] || r_p_pkg.data_valid[2];
    data_valid[3] &= !(r_p_pkg.src_preg[3] == r_p_pkg.preg[0] && r_p_pkg.w_reg[0] && r_p_pkg.r_valid[0]) || !r_p_pkg.reg_need[3] || r_p_pkg.data_valid[3];
end


// alu0: preg 为 偶
// alu1: preg 为 奇
// mdu : 可同时发两条
// lsu : 可同时发两条
logic [1 : 0][1 : 0] choose_alu;
always_comb begin
    for (integer i = 0; i < 2; i++) begin
        choose_alu[i] = '0;
        for (integer j = 0; j < 2; j++) begin
            if ((r_p_pkg.alu_type[j]) & (r_p_pkg.preg[j][0] == i[0]) & (r_p_pkg.r_valid[j])) begin
                choose_alu[i][j[0]] |= '1;
            end
        end
    end
end

logic [1 : 0] choose_mdu;
logic [1 : 0] choose_lsu;
always_comb begin
    choose_mdu = '0;
    choose_lsu = '0;
    for (integer j = 0; j < 2; j++) begin
        if ((r_p_pkg.mdu_type[j]) & (r_p_pkg.r_valid[j])) begin
            choose_mdu[j[0]] |= '1;
        end
        if ((r_p_pkg.lsu_type[j]) & (r_p_pkg.r_valid[j])) begin
            choose_lsu[j[0]] |= '1;
        end
    end
end

// choose 
// 0 1 :  
// 1 0 :
// 1 1 : 
// 0 0 :

p_i_pkg_t [3 : 0] p_i_pkg; // 对应四个发射队列：[3:0]对应lsu,mdu,alu1,alu0
// p_i_pkg_t [3 : 0] p_i_pkg_q; // 握手缓存 /* 2024/07/24 fix*/

// 到四个发射队列的信号的逻辑
always_comb begin
    for (integer i = 0; i < 4; i++) begin
        p_i_pkg[i].data = sel_data;
        p_i_pkg[i].preg = r_p_pkg.src_preg;
        p_i_pkg[i].data_valid = data_valid;
        p_i_pkg[i].r_valid    = r_p_pkg.r_valid;
        // 控制信号TODO
        p_i_pkg[i].imm = r_p_pkg.addr_imm;
        // ALU & MDU 信号
        p_i_pkg[i].grand_op = r_p_pkg.grand_op;
        p_i_pkg[i].op = r_p_pkg.op;
        // LSU 信号
        p_i_pkg[i].msigned = r_p_pkg.msigned;
        p_i_pkg[i].msize = r_p_pkg.msize; // 没啥用
        p_i_pkg[i].w_mem = r_p_pkg.w_mem;
        p_i_pkg[i].di = {p_di[1], p_di[0]};
    end
    p_i_pkg[0].inst_choose = choose_alu[0];
    p_i_pkg[1].inst_choose = choose_alu[1];
    p_i_pkg[2].inst_choose = choose_mdu;
    p_i_pkg[3].inst_choose = choose_lsu;
end

// 到四个发射队列的 decode_info_t 逻辑
for (genvar i = 0; i < 2; i=i+1) begin
    assign p_di[i].pc = r_p_pkg.pc[i];
    assign p_di[i].imm = r_p_pkg.addr_imm[i];
    // assign p_di[i].if_jump = r_p_pkg.if_jump[i];
    
    assign p_di[i].grand_op = r_p_pkg.grand_op[i];
    assign p_di[i].op = r_p_pkg.op[i];

    assign p_di[i].wreg_id = r_p_pkg.preg[i];
    assign p_di[i].wreg = r_p_pkg.w_reg[i];
    assign p_di[i].wmem = r_p_pkg.w_mem[i];

    assign p_di[i].msigned = r_p_pkg.msigned[i];
    assign p_di[i].msize = r_p_pkg.msize[i];

    assign p_di[i].is_cacop   = r_p_pkg.cacop_inst[i];
    assign p_di[i].cache_code = r_p_pkg.inst_4_0[i];

    assign p_di[i].inst_valid = r_p_pkg.r_valid[i];
    assign p_di[i].fetch_exc_info = r_p_pkg.fetch_exc_info;
end


// always_ff @(posedge clk) begin
//     // alu_sender0
//     if (p_alu_sender_0.valid & p_alu_sender_0.ready) begin
//         p_i_pkg_q[0] <= p_i_pkg[0];
//     end else begin
//         p_i_pkg_q[0] <= '0;
//     end
//     // alu_sender1
//     if (p_alu_sender_1.valid & p_alu_sender_1.ready) begin
//         p_i_pkg_q[1] <= p_i_pkg[1];
//     end else begin
//         p_i_pkg_q[1] <= '0;
//     end
//     // mdu_sender
//     if (p_mdu_sender.valid & p_mdu_sender.ready) begin
//         p_i_pkg_q[2] <= p_i_pkg[2];
//     end else begin
//         p_i_pkg_q[2] <= '0;
//     end
//     // lsu_sender
//     if (p_lsu_sender.valid & p_lsu_sender.ready) begin
//         p_i_pkg_q[3] <= p_i_pkg[3];
//     end else begin
//         p_i_pkg_q[3] <= '0;
//     end
// end

assign p_alu_sender_0.data = p_i_pkg[0];
assign p_alu_sender_1.data = p_i_pkg[1];
assign p_mdu_sender.data   = p_i_pkg[2];
assign p_lsu_sender.data   = p_i_pkg[3];
assign p_alu_sender_0.valid = r_p_receiver.ready & (|choose_alu[0]);
assign p_alu_sender_1.valid = r_p_receiver.ready & (|choose_alu[1]);
assign p_mdu_sender.valid   = r_p_receiver.ready & (|choose_mdu);
assign p_lsu_sender.valid   = r_p_receiver.ready & (|choose_lsu);




endmodule
