zhhangBian/BOOM_chip/rtl/basic_dpsram.sv

`include "a_defines.svh"

module dpsram #(
    parameter int unsigned DATA_WIDTH = 32  ,
    parameter int unsigned DATA_DEPTH = 1024,
    parameter int unsigned BYTE_SIZE  = 32
) (
    input                                       clk0    ,
    input                                       rst_n0  ,
    input  wire  [$clog2(DATA_DEPTH)-1     : 0] addr0_i ,
    input                                       en0_i   ,
    input        [(DATA_WIDTH/BYTE_SIZE)-1 : 0] we0_i   ,
    input  logic [DATA_WIDTH-1             : 0] wdata0_i,
    output logic [DATA_WIDTH-1             : 0] rdata0_o,

    input                                       clk1    ,
    input                                       rst_n1  ,
    input  wire  [$clog2(DATA_DEPTH)-1     : 0] addr1_i ,
    input  wire                                 en1_i   ,
    input        [(DATA_WIDTH/BYTE_SIZE)-1 : 0] we1_i   ,
    input  logic [DATA_WIDTH-1             : 0] wdata1_i,
    output logic [DATA_WIDTH-1             : 0] rdata1_o
);


`ifdef _FPGA
  logic [(DATA_WIDTH/BYTE_SIZE)-1:0][(BYTE_SIZE/8)-1:0]ext_we0, ext_we1;
  for(genvar i = 0 ; i < (DATA_WIDTH/BYTE_SIZE); i++) begin
    assign ext_we0[i] = we0_i[i] ? '1 : '0;
    assign ext_we1[i] = we1_i[i] ? '1 : '0;
  end
  xpm_memory_tdpram #(
    .ADDR_WIDTH_A       ($clog2(DATA_DEPTH)     ),
    .ADDR_WIDTH_B       ($clog2(DATA_DEPTH)     ),
    .AUTO_SLEEP_TIME    (0                      ), // DECIMAL
    .BYTE_WRITE_WIDTH_A (DATA_WIDTH == BYTE_SIZE ? DATA_WIDTH : 8),
    .BYTE_WRITE_WIDTH_B (DATA_WIDTH == BYTE_SIZE ? DATA_WIDTH : 8),
    .CASCADE_HEIGHT     (0                      ), // DECIMAL
    .CLOCKING_MODE      ("common_clock"         ),
    .ECC_MODE           ("no_ecc"               ),
    .IGNORE_INIT_SYNTH  (0                      ), // DECIMAL
    .MEMORY_INIT_FILE   ("none"                 ),
    .MEMORY_INIT_PARAM  ("0"                    ),
    .MEMORY_OPTIMIZATION("true"                 ),
    .MEMORY_PRIMITIVE   ("auto"                 ), // String
    .MEMORY_SIZE        (DATA_WIDTH * DATA_DEPTH),
    .MESSAGE_CONTROL    (0                      ), // DECIMAL
    .READ_DATA_WIDTH_A  (DATA_WIDTH             ),
    .READ_DATA_WIDTH_B  (DATA_WIDTH             ),
    .READ_LATENCY_A     (1                      ), // DECIMAL
    .READ_LATENCY_B     (1                      ), // DECIMAL
    .USE_MEM_INIT       (0                      ),
    .WRITE_DATA_WIDTH_A (DATA_WIDTH             ),
    .WRITE_DATA_WIDTH_B (DATA_WIDTH             ),
    .WRITE_MODE_A       ("write_first"          ), // String
    .WRITE_MODE_B       ("write_first"          ), // String
    .WRITE_PROTECT      (1                      )  // DECIMAL
  ) xpm_memory_tdpram_inst (
    .douta         (rdata0_o),
    .doutb         (rdata1_o),
    .addra         (addr0_i ),
    .addrb         (addr1_i ),
    .clka          (clk0    ),
    .clkb          (clk1    ),
    .dina          (wdata0_i),
    .dinb          (wdata1_i),
    .ena           (en0_i   ),
    .enb           (en1_i   ),
    .injectdbiterra('0      ),
    .injectdbiterrb('0      ),
    .injectsbiterra('0      ),
    .injectsbiterrb('0      ),
    .regcea        ('1      ),
    .regceb        ('1      ),
    .rsta          (~rst_n0 ),
    .rstb          (~rst_n1 ),
    .sleep         ('0      ),
    .wea           (DATA_WIDTH == BYTE_SIZE ? we0_i : ext_we0),
    .web           (DATA_WIDTH == BYTE_SIZE ? we1_i : ext_we1)
  );
`endif


`ifdef _VERILATOR
  logic [(DATA_WIDTH/BYTE_SIZE)-1:0][BYTE_SIZE-1:0] sim_ram_o[DATA_DEPTH-1:0];
  reg   [(DATA_WIDTH/BYTE_SIZE)-1:0][BYTE_SIZE-1:0] sim_ram[DATA_DEPTH-1:0];
  reg   [(DATA_WIDTH/BYTE_SIZE)-1:0][BYTE_SIZE-1:0] rdata0_split_q,rdata1_split_q;
  logic [(DATA_WIDTH/BYTE_SIZE)-1:0][BYTE_SIZE-1:0] wdata0_split,wdata1_split;

  assign wdata0_split = wdata0_i;
  assign wdata1_split = wdata1_i;
  assign rdata0_o = rdata0_split_q;
  assign rdata1_o = rdata1_split_q;

  assign sim_ram_o = sim_ram;
  
  // initial
  initial begin
    for (integer i = 0; i < DATA_DEPTH ; i++) begin
      for (integer j = 0; j < (DATA_WIDTH/BYTE_SIZE) ; j++) begin
        sim_ram[i][j] = '0;
      end
    end
    for (integer j = 0; j < (DATA_WIDTH/BYTE_SIZE) ; j++) begin
        rdata0_split_q[j] = '0;
        rdata1_split_q[j] = '0;
    end
  end

  // PORT A
  always_ff @(posedge clk0) begin
    if(!rst_n0) begin
    end
    else if(en0_i) begin
        for(integer i = 0 ; i < (DATA_WIDTH/BYTE_SIZE) ; i++) begin
            if(we0_i[i]) begin
                rdata0_split_q[i] <= wdata0_split[i];
            end else begin
                rdata0_split_q[i] <= sim_ram[addr0_i][i];
            end
        end
    end
  end

  // PORT B
  always_ff @(posedge clk1) begin
    if(!rst_n0) begin
        // for(integer i = 0 ; i < (DATA_DEPTH) ; i++) begin
        //     sim_ram[i] <= '0;
        // end
    end
    else if(en1_i) begin
        for(integer i = 0 ; i < (DATA_WIDTH/BYTE_SIZE) ; i++) begin
            if(we1_i[i]) begin
                rdata1_split_q[i]   <= wdata1_split[i];
                sim_ram[addr1_i][i] <= wdata1_split[i];
            end
            else begin
                rdata1_split_q[i]   <= sim_ram[addr1_i][i];
            end
        end
    end
  end
`endif

endmodule
