zhhangBian/BOOM_chip/rtl/arbiter.sv

/*

Copyright (c) 2014-2021 Alex Forencich

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
*/

// Language: Verilog 2001

`resetall
`timescale 1ns / 1ps
`default_nettype none

/*
 * Arbiter module
 */
module arbiter #
(
    parameter PORTS = 4,
    // select round robin arbitration
    parameter ARB_TYPE_ROUND_ROBIN = 0,
    // blocking arbiter enable
    parameter ARB_BLOCK = 0,
    // block on acknowledge assert when nonzero, request deassert when 0
    parameter ARB_BLOCK_ACK = 1,
    // LSB priority selection
    parameter ARB_LSB_HIGH_PRIORITY = 0
)
(
    input  wire                     clk,
    input  wire                     rst,

    input  wire [PORTS-1:0]         request,
    input  wire [PORTS-1:0]         acknowledge,

    output wire [PORTS-1:0]         grant,
    output wire                     grant_valid,
    output wire [$clog2(PORTS)-1:0] grant_encoded
);

reg [PORTS-1:0] grant_reg = 0, grant_next;
reg grant_valid_reg = 0, grant_valid_next;
reg [$clog2(PORTS)-1:0] grant_encoded_reg = 0, grant_encoded_next;

assign grant_valid = grant_valid_reg;
assign grant = grant_reg;
assign grant_encoded = grant_encoded_reg;

wire request_valid;
wire [$clog2(PORTS)-1:0] request_index;
wire [PORTS-1:0] request_mask;

priority_encoder #(
    .WIDTH(PORTS),
    .LSB_HIGH_PRIORITY(ARB_LSB_HIGH_PRIORITY)
)
priority_encoder_inst (
    .input_unencoded(request),
    .output_valid(request_valid),
    .output_encoded(request_index),
    .output_unencoded(request_mask)
);

reg [PORTS-1:0] mask_reg = 0, mask_next;

wire masked_request_valid;
wire [$clog2(PORTS)-1:0] masked_request_index;
wire [PORTS-1:0] masked_request_mask;

priority_encoder #(
    .WIDTH(PORTS),
    .LSB_HIGH_PRIORITY(ARB_LSB_HIGH_PRIORITY)
)
priority_encoder_masked (
    .input_unencoded(request & mask_reg),
    .output_valid(masked_request_valid),
    .output_encoded(masked_request_index),
    .output_unencoded(masked_request_mask)
);

always @* begin
    grant_next = 0;
    grant_valid_next = 0;
    grant_encoded_next = 0;
    mask_next = mask_reg;

    if (ARB_BLOCK && !ARB_BLOCK_ACK && grant_reg & request) begin
        // granted request still asserted; hold it
        grant_valid_next = grant_valid_reg;
        grant_next = grant_reg;
        grant_encoded_next = grant_encoded_reg;
    end else if (ARB_BLOCK && ARB_BLOCK_ACK && grant_valid && !(grant_reg & acknowledge)) begin
        // granted request not yet acknowledged; hold it
        grant_valid_next = grant_valid_reg;
        grant_next = grant_reg;
        grant_encoded_next = grant_encoded_reg;
    end else if (request_valid) begin
        if (ARB_TYPE_ROUND_ROBIN) begin
            if (masked_request_valid) begin
                grant_valid_next = 1;
                grant_next = masked_request_mask;
                grant_encoded_next = masked_request_index;
                if (ARB_LSB_HIGH_PRIORITY) begin
                    mask_next = {PORTS{1'b1}} << (masked_request_index + 1);
                end else begin
                    mask_next = {PORTS{1'b1}} >> (PORTS - masked_request_index);
                end
            end else begin
                grant_valid_next = 1;
                grant_next = request_mask;
                grant_encoded_next = request_index;
                if (ARB_LSB_HIGH_PRIORITY) begin
                    mask_next = {PORTS{1'b1}} << (request_index + 1);
                end else begin
                    mask_next = {PORTS{1'b1}} >> (PORTS - request_index);
                end
            end
        end else begin
            grant_valid_next = 1;
            grant_next = request_mask;
            grant_encoded_next = request_index;
        end
    end
end

always @(posedge clk) begin
    if (rst) begin
        grant_reg <= 0;
        grant_valid_reg <= 0;
        grant_encoded_reg <= 0;
        mask_reg <= 0;
    end else begin
        grant_reg <= grant_next;
        grant_valid_reg <= grant_valid_next;
        grant_encoded_reg <= grant_encoded_next;
        mask_reg <= mask_next;
    end
end

endmodule

`resetall
