zhhangBian/BOOM_chip/(commit log)

2024-07-05 更新了前端的握手信号
2024-07-05 添加了命名规范
2024-07-05 更新了命名规范
2024-07-05 [E] 完成了初版的ALU和宏定义
2024-07-05 添加了公用IP
2024-07-05 dpsram 初始化
2024-07-05 完成了一半的乘法器和除法器
2024-07-06 加入arfid 和 robid定义
2024-07-06 修正了mdu中的bug
2024-07-06 添加了rob和ARF宽度
2024-07-06 P级文档
2024-07-06 Dispatch文档
2024-07-06 根据rat特性修改了bug
2024-07-07 rob signal 定义
2024-07-07 完成data表和inst表，还剩下complete表，完成之后可实现DISPATCH模块，IQ
2024-07-08 rob alpha 未检查
2024-07-08 握手信号和与cdb及rob交互信号定义完成
2024-07-08 更改了一些register的bank读口数，使用fpga ram资源
2024-07-08 一些修改
2024-07-08 添加了jump模块
2024-07-08 增加rename级和dispatch级握手的valid信号
2024-07-08 传入r_p和d_r级信号包
2024-07-08 更新jump
2024-07-09 加入inst type定义
2024-07-09 添加了完成了部分的IQ
2024-07-09 修改了IQ两个表项
2024-07-09 进行了一点小更改
2024-07-09 更新了IQ
2024-07-09 新增2r1w和6r1w的fpga_ram
2024-07-09 增加2r1w和6r1w的端口
2024-07-09 修改变量名称
2024-07-10 改了一个小bug
2024-07-10 改了一个小bug，准备测试
2024-07-10 更新了IQ_entry的表项
2024-07-10 完成IQ，等待接线
2024-07-10 更改了data_imm数据 DEPTH
2024-07-10 新增sb_entry_t
2024-07-10 关于data_imm位宽的一个小bug
2024-07-10 完善了ALU_IQ
2024-07-10 完成了ALU_IQ
2024-07-10 完善了AGING算法
2024-07-10 完成了MDU_IQ，完善了ALU_IQ
2024-07-10 一个小bug
2024-07-11 修改了tlb_defines
2024-07-11 关于rob的一点小改动
2024-07-11 去掉了最后的fifo
2024-07-11 IQ完成，并接上了接口
2024-07-11 fix a small bug
    [p_rob.sv]
2024-07-12 修复lIQ中的bug
2024-07-12 增加了p级到i级的握手
2024-07-12 完善了IQ
2024-07-12 优化了ready逻辑
2024-07-12 小bug
2024-07-12 完善了三个IQ
2024-07-13 规范了命名
2024-07-13 fix a small bug
    [i_alu_iq.sv, i_data_wkup.sv]
2024-07-13 finish cdb 等待测试
2024-07-13 更改了IQ方式
2024-07-13 上传讨论结果
2024-07-14 接上来IQ的LSU和MDU接口
2024-07-14 重新设计
2024-07-14 新的storebuf
2024-07-15 更改rob逻辑
2024-07-16 修复IQ
2024-07-16 完成了commit的状态机，并检查了
2024-07-17 修复了uncached情况下的请求
2024-07-17 完成CSR
2024-07-17 调整了计算的寄存器顺序
2024-07-17 dcache a small bug
    [m_dcache.sv]
2024-07-17 修改了一些小bug
2024-07-17 增加sram控制信号
2024-07-17 对访存状态机进行了改写
2024-07-17 finish frontend top design, need to fix decoder, bpu and icache
    [b_bpu.sv, d_decoder.sv, mycpu_top.sv]
2024-07-17 初步修复bug
2024-07-17 修复bug
2024-07-17 全部修完了！
2024-07-17 居然漏了一个小bug
2024-07-17 完善了接口
2024-07-18 完成了Cache维护指令
2024-07-18 [fix]: adapt decoder to d_r_pkg_t
    [basic_decoder.sv, d_decoder.sv, mycpu_top.sv]
2024-07-18 修改了way_hit路命中信号的特性
2024-07-18 一些小改动
2024-07-18 增加了解释信息
2024-07-18 给异常处理开辟空间
2024-07-18 完善了Cache维护指令
2024-07-18 完成了arf提交
2024-07-19 [fix]: tag - half done, tmp commit
    [b_bpu.sv]
2024-07-19 [fix]: bpu, finally done
    [b_bpu.sv]
2024-07-19 专门增加了cacop指令直接地址映射的dirty位
2024-07-19 完善了cache与commit交互的结构体
2024-07-19 完善lsu写回cpu的数据交互结构体
2024-07-19 [fix]: bpu bug, 实例化 axi-crossbar
    [b_bpu.sv, mycpu_top.sv]
2024-07-19 完成了分支预测接口
2024-07-19 更改b_f_pkg_t名称
2024-07-19 fix: '1 bug in decode and bpu
    [b_bpu.sv, d_decoder.sv]
2024-07-19 完成了AXI握手信号
2024-07-20 完成了与Icache的握手
2024-07-20 修改了与BPU端口的命名问题
2024-07-20 fix: slight change in correct_info in bpu and c_commit
    [b_bpu.sv, c_commit.sv]
2024-07-20 添加了ICache的flush逻辑
2024-07-20 增加了和commit的交互信息
2024-07-20 更新Icache
2024-07-20 fix: adapt bpu to commit; better coding style
    [b_bpu.sv, d_decoder.sv]
2024-07-20 维护ll_sc
2024-07-20 保留Icache请求
2024-07-20 修复输入不带logic的错误
2024-07-20 flush时的PC逻辑
2024-07-20 修改命名错误
2024-07-20 fix: mycpu_top and 2x1 axi crossbar interface declaration
    [mycpu_top.sv]
2024-07-20 fix: mycpu_top 连线了一点点
2024-07-20 icache的pc对齐
2024-07-20 搭建了初步的屎山
2024-07-20 接上部分线
2024-07-20 去wired化
2024-07-20 供奉龙芯杯吉祥物
2024-07-20 fix an exception jump addr bug
    [c_commit.sv]
2024-07-20 fix a small bug relating llbit
    [c_commit.sv]
2024-07-20 check commit csr and tlb, fix several bugs
    [c_commit.sv]
2024-07-21 fix: compile error in decoder
    [basic_decoder.sv]
2024-07-21 梳理了连接过程
2024-07-21 修正IQ惊天大bug
2024-07-21 修正IQ的部分逻辑
2024-07-21 加入了IQ的齐步走逻辑
2024-07-21 修改了握手信号
2024-07-21 修复查找替换过于激进p_valid_i
2024-07-21 完善了某些信号
2024-07-21 加入cdb信号
2024-07-21 fix: adapt decoder to alu
    [basic_decoder.sv, c_commit.sv]
2024-07-21 Cache状态机异常处理
2024-07-21 完善icache和commit状态机握手
2024-07-21 fix: adapt decoder to alu in COM part
    [basic_decoder.sv]
2024-07-21 适配接口
2024-07-21 fix: bpu flush and redir_addr
    [b_bpu.sv, mycpu_top.sv]
2024-07-21 fix: bpu interface in top design
    [mycpu_top.sv]
2024-07-21 添加decode_info_t
2024-07-21 Cdb和wkup信号接上
2024-07-21 调整了cache状态机的way_choose
2024-07-21 icache和commit交互接口
2024-07-21 fix: naming of decode signal
    [basic_decoder.sv]
2024-07-21 更新Icache接口
2024-07-21 fix: bug in decoder
    [basic_decoder.sv, d_decoder.sv]
2024-07-21 决斗！最终AXI接口
2024-07-21 bug on commit condition
    [c_commit.sv]
2024-07-21 fix: bpu correct logic in commit
    [c_commit.sv]
2024-07-21 fix: a lot of bpu bugs
    [b_bpu.sv]
2024-07-21 commit状态机1.0版本
2024-07-21 更改了axi握手部分
2024-07-22 commit状态机重写v0.5
2024-07-22 修改commit状态机v0.6
2024-07-22 提供了重填数据地址
2024-07-22 重写commit状态机v1.0
2024-07-22 修改axi握手逻辑
2024-07-22 修改AXI握手时序
2024-07-22 完善状态机的复位逻辑
2024-07-22 fix: big changes in decoder and a_structure
    [basic_decoder.sv, d_decoder.sv]
2024-07-22 icache状态机完善
2024-07-22 修正commit部分逻辑
2024-07-22 完成了AXI的外部接线
2024-07-22 修改一些控制信号，接一些线
2024-07-22 fix some small bug
    [d_decoder.sv, mycpu_top.sv]
2024-07-22 增加了rmask和strb逻辑
2024-07-22 删除了jump模块
2024-07-22 调整了宏文件引用逻辑
2024-07-22 优化了mdu握手逻辑
2024-07-22 修复了部分语法bug
2024-07-22 lsu_pkg增加了msigned和msize
2024-07-22 ____>_?记住这一版，可能要回退?<_____
2024-07-22 fix: remove unnecessary header; some compile error
    [b_bpu.sv, d_decoder.sv]
2024-07-22 编译中途结果
2024-07-22 编译1.0
2024-07-22 ==注意：ROB还没有接完！！！！！！===
2024-07-23 消除warning
2024-07-23 fix: remove some unnecessary code in rob
    [p_rob.sv]
2024-07-23 fix: some compile error, modify a_interface.svh
    [mycpu_top.sv]
2024-07-23 fix: some compile error
    [mycpu_top.sv, p_rob.sv, r_rename.sv]
2024-07-23 iq增加源操作数输出
2024-07-23 部分修改
2024-07-23 fix: more compile error
    [b_bpu.sv, basic_decoder.sv, c_commit.sv, e_alu.sv, f_icache.sv, i_alu_iq.sv, i_iq_entry.sv, i_mdu_iq.sv]
2024-07-23 mdu修改
2024-07-23 mdu线没定义
2024-07-23 fix: more compile error in commit
    [c_commit.sv]
2024-07-23 部分bug
2024-07-23 fix: decoder compile error
    [d_decoder.sv]
2024-07-23 commit some compile error
    [c_commit.sv]
2024-07-23 commit接口部分bug
2024-07-23 修正顶层bug
2024-07-23 修正了cdb_cdb的错误
2024-07-23 IQ和mdu的bug
2024-07-23 rename级check信号通路完成
2024-07-23 check信号完善
2024-07-23 fix: bpu and decoder compile error
    [b_bpu.sv, basic_decoder.sv]
2024-07-23 icache 修正
2024-07-23 redir_addr链接
2024-07-23 格式更改
2024-07-23 fix: more decoder and bpu compile error; change in rob
    [basic_decoder.sv, d_decoder.sv, mycpu_top.sv, p_rob.sv]
2024-07-23 顶层fifo接口
2024-07-23 fix: rob compile error
    [p_rob.sv]
2024-07-23 顶层bug
2024-07-23 fix: more rob compile error
    [p_dispatch.sv, p_rob.sv]
2024-07-23 位宽bug fix
2024-07-23 commit赋值问题解决
2024-07-23 解决latch
2024-07-23 添加gitignore
2024-07-23 修改部分数组形式
2024-07-23 修改了小Bug
2024-07-23 接上顶层接口
2024-07-23 数组问题
2024-07-23 fix some witdth problem
    [basic_mmu_beifen.sv, c_commit.sv]
2024-07-23 解决环路
2024-07-23 去掉di_o，但是没用
2024-07-23 fix: verilog-axi [-1:0] warning; if_jump
    [axi_crossbar_addr.sv, axi_crossbar_rd.sv, axi_crossbar_wr.sv, b_bpu.sv, d_decoder.sv, p_dispatch.sv, p_rob.sv, r_rename.sv]
2024-07-23 部分warning
2024-07-23 iq_entry和iq_data_wkup warning解决
2024-07-23 消除更多的warning, iq逻辑修正
2024-07-24 修完了IQ和Commit相关的warning
2024-07-24 消除一些warning
2024-07-24 fix: bpu syntax error
    [b_bpu.sv, basic_decoder.sv]
2024-07-24 修正部分bug
2024-07-24 对上mdu位宽
2024-07-24 同样的lsu位宽问题
2024-07-24 di位宽问题
2024-07-24 修正icache的错误
2024-07-24 修改addr-》tag位宽
2024-07-24 修改部分位宽问题
2024-07-24 修复位宽问题
2024-07-24 fix: branch correct and predict bugs
    [b_bpu.sv, c_commit.sv, mycpu_top.sv]
2024-07-24 fix: circular logic warning in commit and mycpu_top
    [c_commit.sv, mycpu_top.sv]
2024-07-24 纠正cnt与valid之间的关系
2024-07-24 another_exception 更正
2024-07-24 fix: bpu initial problem
    [b_bpu.sv, c_commit.sv, mycpu_top.sv]
2024-07-30 add: 总线文件夹
2024-08-20 装点门面
2024-08-20 修改报告中的图片相对地址
